mfacton/battle-bot/notes.txt

4s 850mah + 850mah
total 1700mah

Using 50A omni-wheels

40A is good softness
polyurethane rubber

14awg wire for split pigtails
10awg wire for combined wire

hello
