mfacton/battle-bot/pcb/battle-bot.step

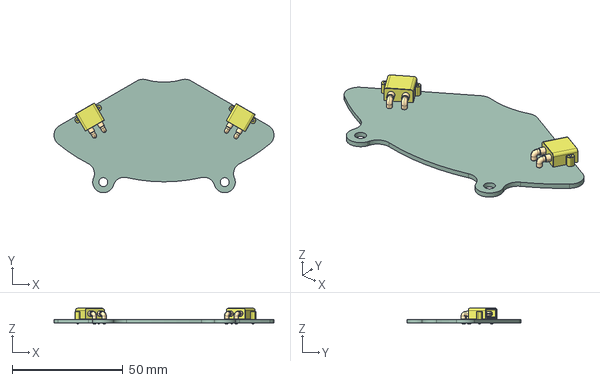
[picture p1: CAD file, 2024-11-22]
pcb/battle-bot.step
99.2 x 51.2 x 7.00 mm
XT30PW-M x 2
battle-bot_PCB
