mfacton/battle-bot/pcb/battle-bot.kicad_pcb

## KiCad design pcb/battle-bot.kicad_pcb (2024-11-30)

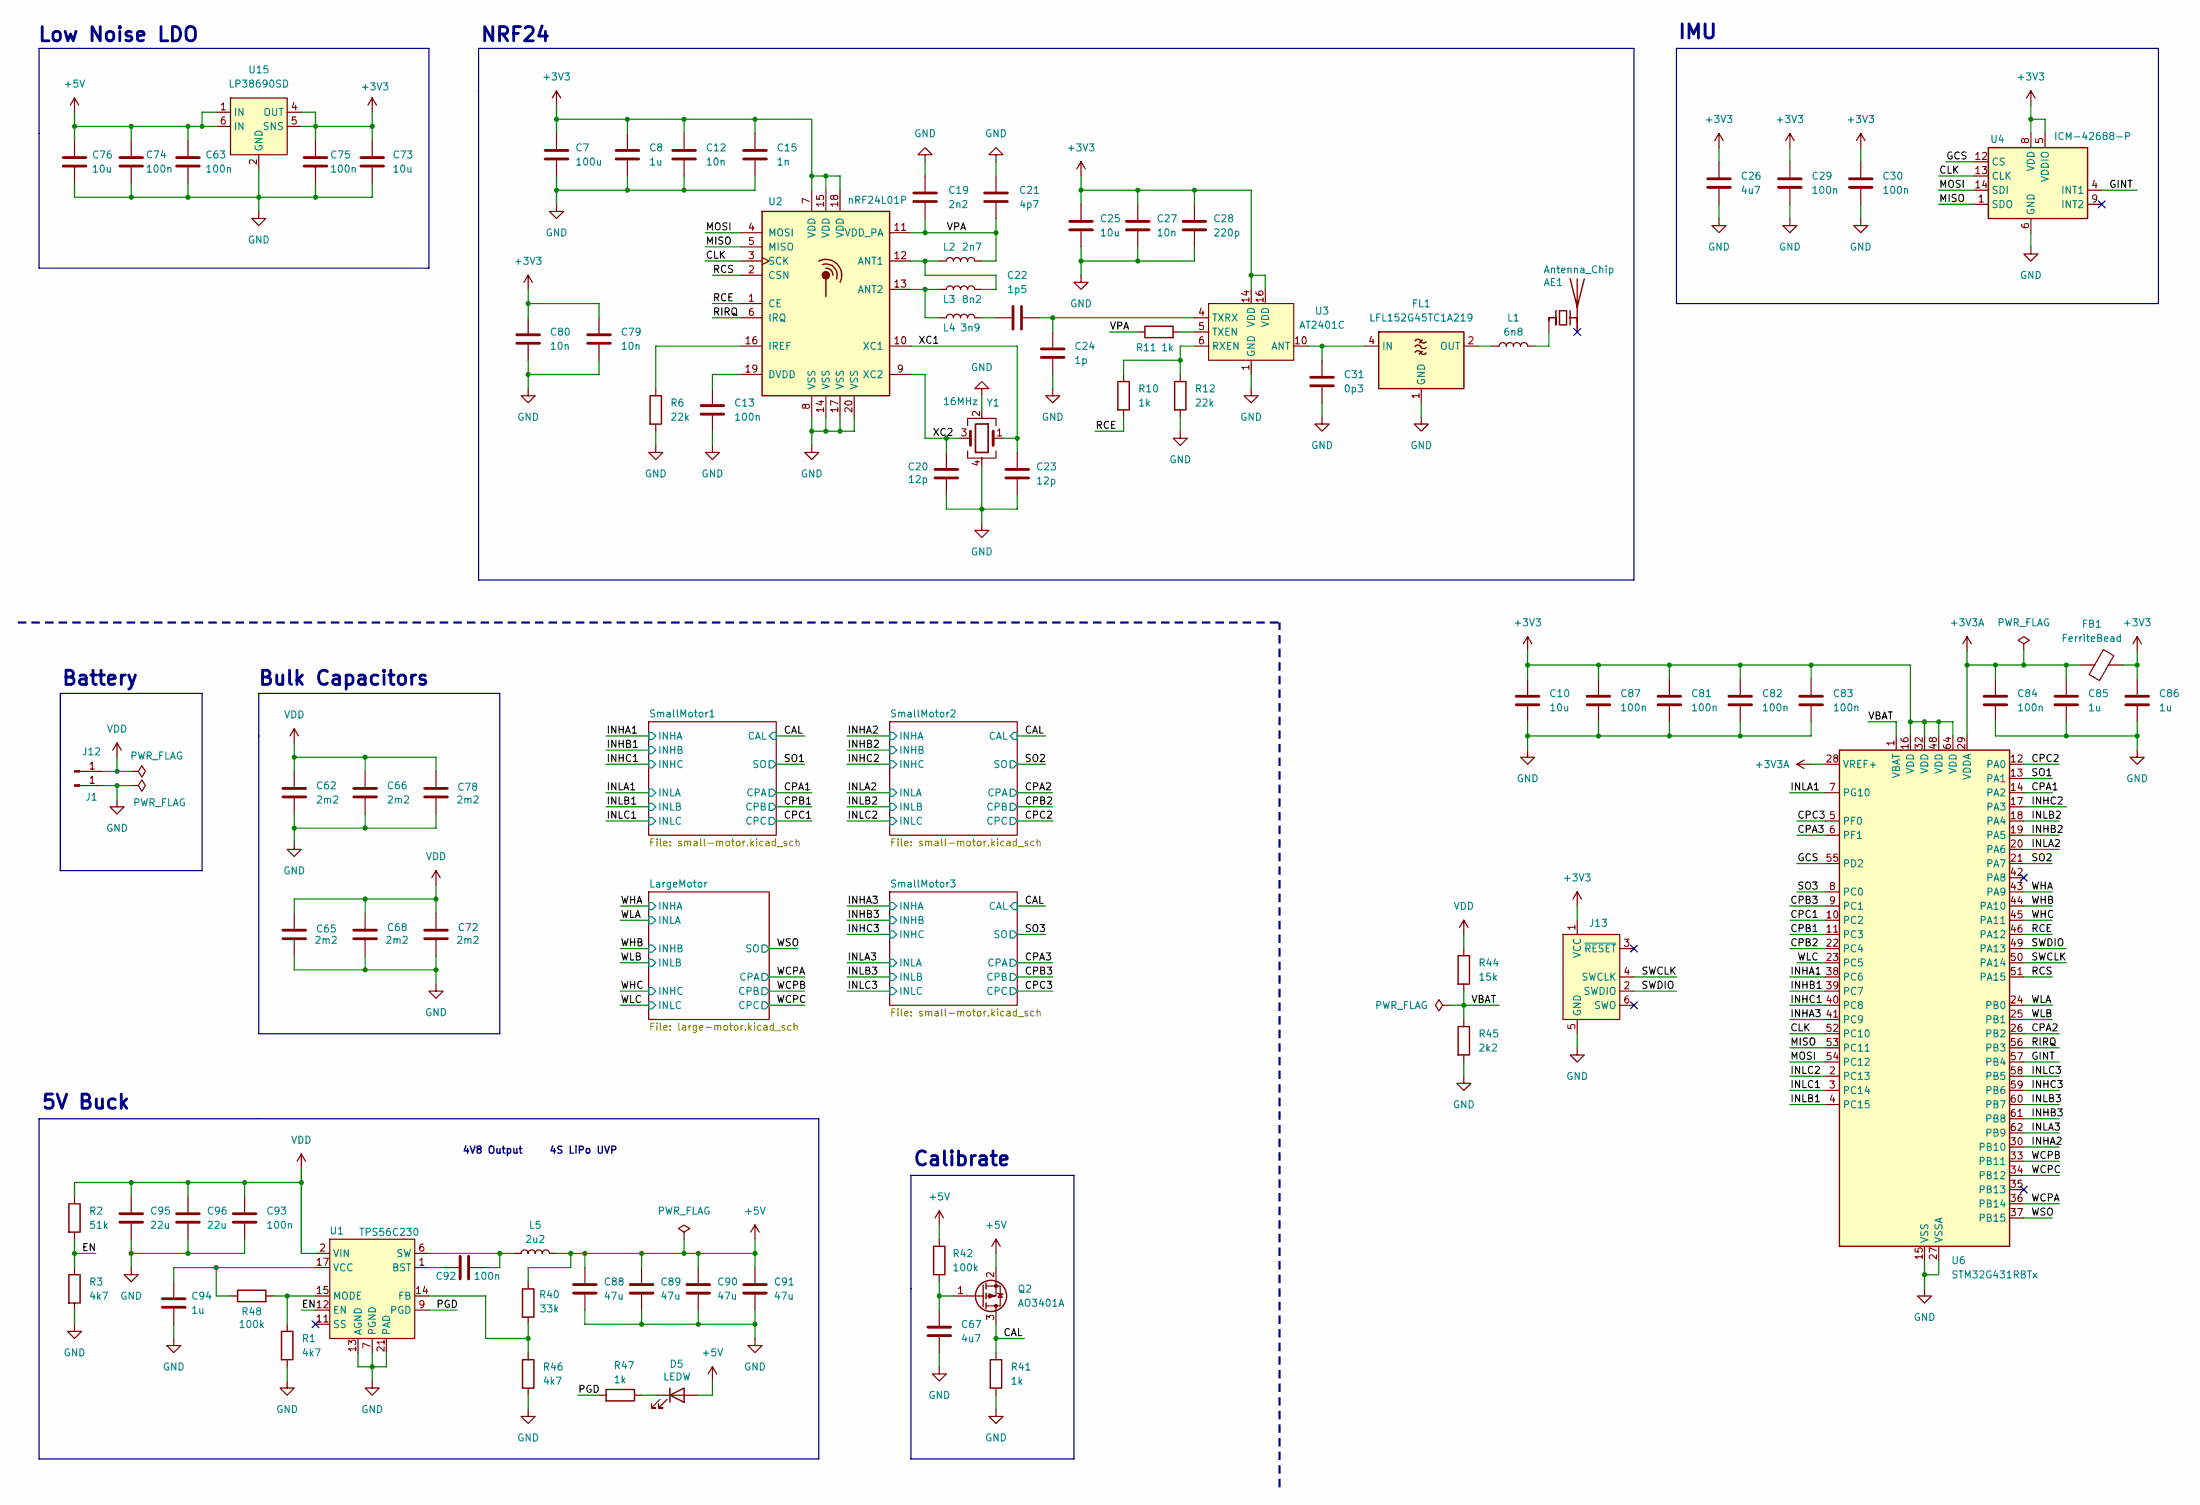
[picture p2: schematic battle-bot.kicad_sch]

Parts:
AE1: Antenna_Chip; Johanson_2450AT18x100; LCSC C127629
C7: 100u; C_1206_3216Metric; LCSC C15008
C8, C85, C86, C94: 1u; C_0402_1005Metric; LCSC C52923
C10, C25, C73: 10u; C_0402_1005Metric; LCSC C15525
C12, C27, C79, C80: 10n; C_0402_1005Metric; LCSC C15195
C13, C29, C30, C63, C74, C75, C81, C82, C83, C84, C87, C92: 100n; C_0402_1005Metric; LCSC C1525
C15: 1n; C_0402_1005Metric; LCSC C1523
C19: 2n2; C_0402_1005Metric; LCSC C1531
C20, C23: 12p; C_0402_1005Metric; LCSC C1547
C21: 4p7; C_0402_1005Metric; LCSC C1569
C22: 1p5; C_0402_1005Metric; LCSC C1552
C24: 1p; C_0402_1005Metric; LCSC C1550
C26, C67: 4u7; C_0402_1005Metric; LCSC C23733
C28: 220p; C_0402_1005Metric; LCSC C1530
C31: 0p3; C_0402_1005Metric; LCSC C880415
C62, C65, C66, C68, C72, C78: 2m2; C_D10xL16_Horizontal; LCSC C5438720
C76: 10u; C_0603_1608Metric; LCSC C19702
C88, C89, C90, C91: 47u; C_1206_3216Metric; LCSC C96123
C93: 100n; C_0402_1005Metric; LCSC C307331
C95, C96: 22u; C_0805_2012Metric; LCSC C45783
D5: LEDW; LED_0603_1608Metric; LCSC C2290
FB1: FerriteBead; L_0805_2012Metric; LCSC C1017
FL1: LFL152G45TC1A219; LCSC C91610
J1, J12: Conn_01x01_Pin; MountingHole_3.2mm_M3_Pad_Via
J13: Conn_ARM_SWD_TagConnect_TC2030-NL; Tag-Connect_TC2030-IDC-NL_2x03_P1.27mm_Vertical
L1: 6n8; L_0402_1005Metric; LCSC C82919
L2: 2n7; L_0402_1005Metric; LCSC C162541
L3: 8n2; L_0402_1005Metric; LCSC C84404
L4: 3n9; L_0402_1005Metric; LCSC C14033
L5: 2u2; L_Chilisin_BMRB00060618; LCSC C216189
Q2: AO3401A; SOT-23; LCSC C15127
R1, R3, R46: 4k7; R_0402_1005Metric; LCSC C25900
R2: 51k; R_0402_1005Metric; LCSC C25794
R6, R12: 22k; R_0402_1005Metric; LCSC C25768
R10, R11, R41, R47: 1k; R_0402_1005Metric; LCSC C11702
R40: 33k; R_0402_1005Metric; LCSC C25779
R42, R48: 100k; R_0402_1005Metric; LCSC C25741
R44: 15k; R_0402_1005Metric; LCSC C25756
R45: 2k2; R_0402_1005Metric; LCSC C25879
U1: TPS56C230; VQFN-20_3x3mm_P0.45; LCSC C1849534
U2: nRF24L01P; QFN-20-1EP_4x4mm_P0.5mm_EP2.5x2.5mm; LCSC C8791
U3: AT2401C; QFN-16-1EP_3x3mm_P0.5mm_EP1.7x1.7mm; LCSC C783588
U4: ICM-42688-P; LGA-14_3x2.5mm_P0.5mm_LayoutBorder3x4y
U6: STM32G431RBTx; LQFP-64_10x10mm_P0.5mm; LCSC C431633
U15: LP38690SD; DFN-6-1EP_3x3mm_P0.95mm_EP1.7x2.6mm; LCSC C130003
Y1: 16MHz; Crystal_SMD_3225-4Pin_3.2x2.5mm; LCSC C13738

Connections:
+3V3: C7.1, C8.1, C10.1, C12.1, C15.1, C25.1, C26.1, C27.1, C28.1, C29.1, C30.1, C73.1, C75.1, C79.1, C80.1, C81.1, C82.1, C83.1, C86.1, C87.1, FB1.2, J13.1 (VCC), U2.7 (VDD), U2.15 (VDD), U2.18 (VDD), U3.14 (VDD), U3.16 (VDD), U4.5 (VDDIO), U4.8 (VDD), U6.16 (VDD), U6.32 (VDD), U6.48 (VDD), U6.64 (VDD), U15.4 (OUT), U15.5 (SNS); also elsewhere on the board
+3V3A: C84.1, C85.1, FB1.1, U6.28 (VREF+), U6.29 (VDDA)
+5V: C63.1, C74.1, C76.1, C88.1, C89.1, C90.1, C91.1, D5.2 (A), L5.2, Q2.2 (S), R40.1, R42.1, U15.1 (IN), U15.6 (IN); also elsewhere on the board
/CAL: Q2.3 (D), R41.1; also elsewhere on the board
/CLK: U2.3 (SCK), U4.13 (CLK), U6.52 (PC10)
/CPA1: U6.14 (PA2); also elsewhere on the board
/CPA2: U6.26 (PB2); also elsewhere on the board
/CPA3: U6.6 (PF1); also elsewhere on the board
/CPB1: U6.11 (PC3); also elsewhere on the board
/CPB2: U6.22 (PC4); also elsewhere on the board
/CPB3: U6.9 (PC1); also elsewhere on the board
/CPC1: U6.10 (PC2); also elsewhere on the board
/CPC2: U6.12 (PA0); also elsewhere on the board
/CPC3: U6.5 (PF0); also elsewhere on the board
/EN: R2.2, R3.1, U1.12 (EN)
/GCS: U4.12 (CS), U6.55 (PD2)
/GINT: U4.4 (INT1), U6.57 (PB4)
/INHA1: U6.38 (PC6); also elsewhere on the board
/INHA2: U6.30 (PB10); also elsewhere on the board
/INHA3: U6.41 (PC9); also elsewhere on the board
/INHB1: U6.39 (PC7); also elsewhere on the board
/INHB2: U6.19 (PA5); also elsewhere on the board
/INHB3: U6.61 (PB8); also elsewhere on the board
/INHC1: U6.40 (PC8); also elsewhere on the board
/INHC2: U6.17 (PA3); also elsewhere on the board
/INHC3: U6.59 (PB6); also elsewhere on the board
/INLA1: U6.7 (PG10); also elsewhere on the board
/INLA2: U6.20 (PA6); also elsewhere on the board
/INLA3: U6.62 (PB9); also elsewhere on the board
/INLB1: U6.4 (PC15); also elsewhere on the board
/INLB2: U6.18 (PA4); also elsewhere on the board
/INLB3: U6.60 (PB7); also elsewhere on the board
/INLC1: U6.3 (PC14); also elsewhere on the board
/INLC2: U6.2 (PC13); also elsewhere on the board
/INLC3: U6.58 (PB5); also elsewhere on the board
/MISO: U2.5 (MISO), U4.1 (SDO), U6.53 (PC11)
/MOSI: U2.4 (MOSI), U4.14 (SDI), U6.54 (PC12)
/PGD: R47.2, U1.9 (PGD)
/RCE: R10.2, U2.1 (CE), U6.46 (PA12)
/RCS: U2.2 (CSN), U6.51 (PA15)
/RIRQ: U2.6 (IRQ), U6.56 (PB3)
/SO1: U6.13 (PA1); also elsewhere on the board
/SO2: U6.21 (PA7); also elsewhere on the board
/SO3: U6.8 (PC0); also elsewhere on the board
/SWCLK: J13.4 (SWCLK), U6.50 (PA14)
/SWDIO: J13.2 (SWDIO), U6.49 (PA13)
/VBAT: R44.2, R45.1, U6.1 (VBAT)
/VPA: C19.2, C21.1, L2.2, R11.1, U2.11 (VDD_PA)
/WCPA: U6.36 (PB14); also elsewhere on the board
/WCPB: U6.33 (PB11); also elsewhere on the board
/WCPC: U6.34 (PB12); also elsewhere on the board
/WHA: U6.43 (PA9); also elsewhere on the board
/WHB: U6.44 (PA10); also elsewhere on the board
/WHC: U6.45 (PA11); also elsewhere on the board
/WLA: U6.24 (PB0); also elsewhere on the board
/WLB: U6.25 (PB1); also elsewhere on the board
/WLC: U6.23 (PC5); also elsewhere on the board
/WSO: U6.37 (PB15); also elsewhere on the board
/XC1: C23.1, U2.10 (XC1), Y1.1
/XC2: C20.2, U2.9 (XC2), Y1.3
GND: C7.2, C8.2, C10.2, C12.2, C13.2, C15.2, C19.1, C20.1, C21.2, C23.2, C24.2, C25.2, C26.2, C27.2, C28.2, C29.2, C30.2, C31.2, C62.2, C63.2, C65.2, C66.1, C67.2, C68.2, C72.2, C73.2, C74.2, C75.2, C76.2, C78.2, C79.2, C80.2, C81.2, C82.2, C83.2, C84.2, C85.2, C86.2, C87.2, C88.2, C89.2, C90.2, C91.2, C93.2, C94.2, C95.2, C96.2, FL1.1 (GND), FL1.3 (GND), J1.1, J13.5 (GND), R1.2, R3.2, R6.2, R12.2, R41.2, R45.2, R46.2, U1.7 (PGND), U1.8 (PGND), U1.10 (NC), U1.13 (AGND), U1.16 (NC), U1.18 (PGND), U1.21 (PAD), U2.8 (VSS), U2.14 (VSS), U2.17 (VSS), U2.20 (VSS), U2.21 (VSS), U3.1 (GND), U3.2 (GND), U3.3 (GND), U3.7 (GND), U3.8 (GND), U3.9 (GND), U3.11 (GND), U3.12 (GND), U3.15 (GND), U3.17 (GND), U4.6 (GND), U4.7 (RESV), U4.11 (RESV), U6.15 (VSS), U6.27 (VSSA), U6.31 (VSS), U6.47 (VSS), U6.63 (VSS), U15.2 (GND), U15.7 (PAD), Y1.2, Y1.4; also elsewhere on the board
unnamed: AE1.1 (FEED), L1.2
unnamed: C22.1, L4.2
unnamed: C92.1, L5.1, U1.6 (SW), U1.19 (SW), U1.20 (SW)
unnamed: D5.1 (K), R47.1
unnamed: C31.1, FL1.4 (IN), U3.10 (ANT)
unnamed: FL1.2 (OUT), L1.1
unnamed: C67.1, Q2.1 (G), R42.2
unnamed: C92.2, U1.1 (BST)
unnamed: R40.2, R46.1, U1.14 (FB)
unnamed: R1.1, R48.2, U1.15 (MODE)
unnamed: C94.1, R48.1, U1.17 (VCC)
unnamed: L2.1, L3.2, U2.12 (ANT1)
unnamed: L3.1, L4.1, U2.13 (ANT2)
unnamed: C13.1, U2.19 (DVDD)
unnamed: R6.1, U2.16 (IREF)
unnamed: R10.1, R12.1, U3.6 (RXEN)
unnamed: R11.2, U3.5 (TXEN)
unnamed: C22.2, C24.1, U3.4 (TXRX)
VDD: C62.1, C65.1, C66.2, C68.1, C72.1, C78.1, C93.1, C95.1, C96.1, J12.1, R2.1, R44.1, U1.2 (VIN), U1.3 (VIN), U1.4 (VIN), U1.5 (VIN); also elsewhere on the board

Notes on the sheet:
Low Noise LDO
IMU
5V Buck
4S LiPo UVP
4V8 Output
Bulk Capacitors
Battery
Calibrate
NRF24

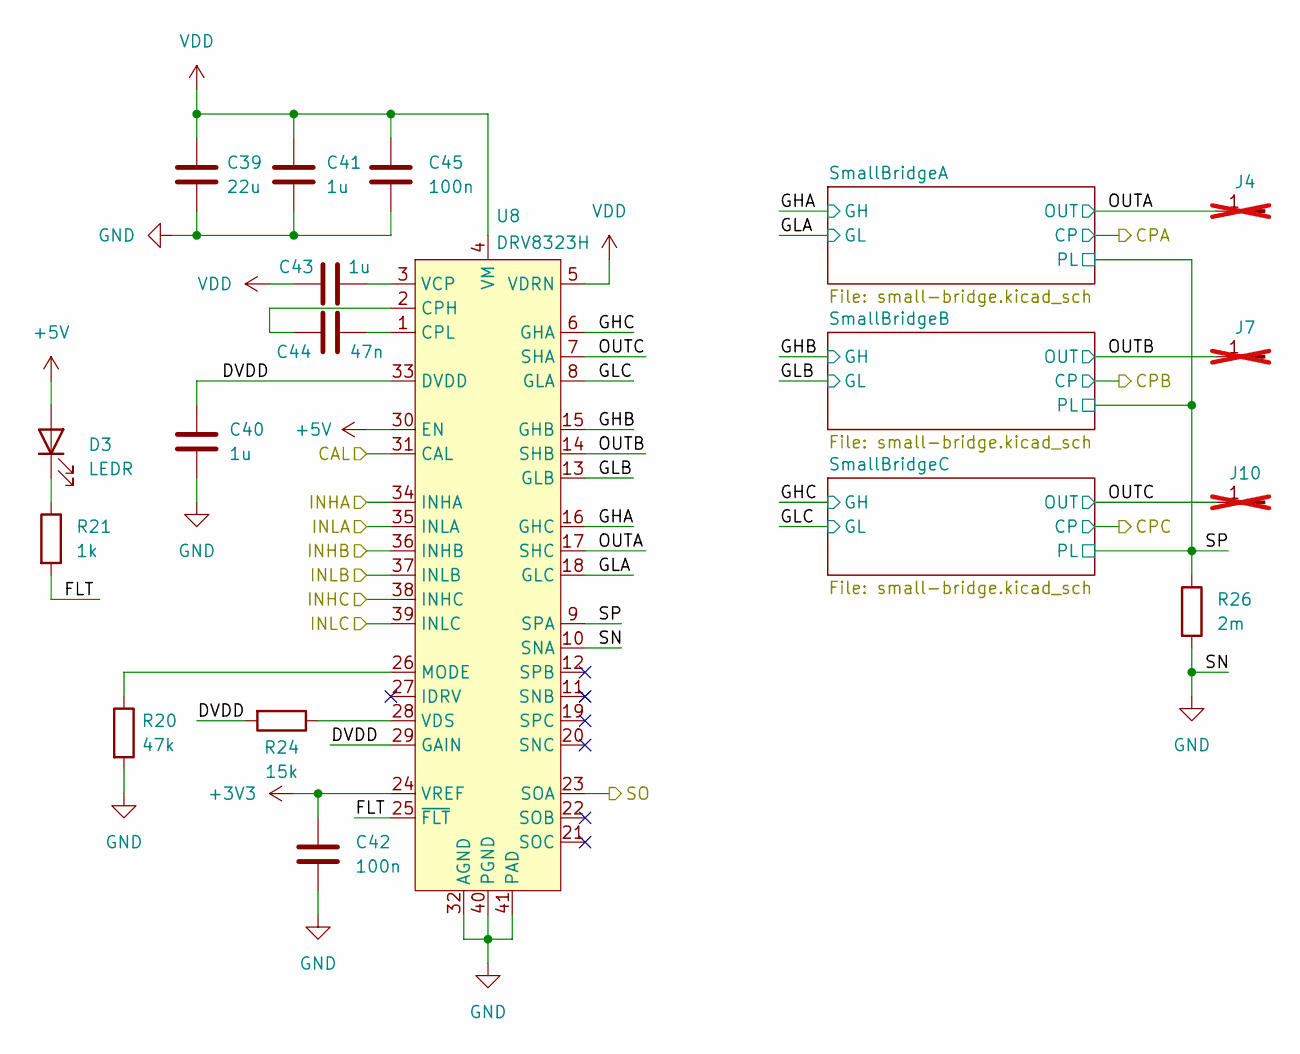
[picture p3: schematic small-motor.kicad_sch]

Parts:
C39: 22u; C_0805_2012Metric; LCSC C45783
C40, C43: 1u; C_0402_1005Metric; LCSC C52923
C41: 1u; R_0402_1005Metric; LCSC C52923
C42: 100n; C_0402_1005Metric; LCSC C1525
C44: 47n; C_0603_1608Metric; LCSC C1622
C45: 100n; C_0402_1005Metric; LCSC C307331
D3: LEDR; LED_0603_1608Metric; LCSC C2286
J4, J7, J10: Conn_01x01_Pin; Pad-P1.5; not fitted
R20: 47k; R_0402_1005Metric; LCSC C25792
R21: 1k; R_0402_1005Metric; LCSC C11702
R24: 15k; R_0402_1005Metric; LCSC C25756
R26: 2m; R_1206_3216Metric; LCSC C601094
U8: DRV8323H; HVQFN-40-1EP_6x6mm_P0.5mm_EP4.1x4.1mm; LCSC C701783

Connections:
+3V3: C42.1, U8.24 (VREF); also elsewhere on the board
+5V: D3.2 (A), U8.30 (EN); also elsewhere on the board
/CAL: U8.31 (CAL); also elsewhere on the board
/INHA2: U8.34 (INHA); also elsewhere on the board
/INHB2: U8.36 (INHB); also elsewhere on the board
/INHC2: U8.38 (INHC); also elsewhere on the board
/INLA2: U8.35 (INLA); also elsewhere on the board
/INLB2: U8.37 (INLB); also elsewhere on the board
/INLC2: U8.39 (INLC); also elsewhere on the board
/SO2: U8.23 (SOA); also elsewhere on the board
/SmallMotor2/DVDD: C40.1, R24.2, U8.29 (GAIN), U8.33 (DVDD)
/SmallMotor2/FLT: R21.2, U8.25 (~FLT)
/SmallMotor2/GHA: U8.16 (GHC); also elsewhere on the board
/SmallMotor2/GHB: U8.15 (GHB); also elsewhere on the board
/SmallMotor2/GHC: U8.6 (GHA); also elsewhere on the board
/SmallMotor2/GLA: U8.18 (GLC); also elsewhere on the board
/SmallMotor2/GLB: U8.13 (GLB); also elsewhere on the board
/SmallMotor2/GLC: U8.8 (GLA); also elsewhere on the board
/SmallMotor2/OUTA: J4.1, U8.17 (SHC); also elsewhere on the board
/SmallMotor2/OUTB: J7.1, U8.14 (SHB); also elsewhere on the board
/SmallMotor2/OUTC: J10.1, U8.7 (SHA); also elsewhere on the board
/SmallMotor2/SP: R26.1, U8.9 (SPA); also elsewhere on the board
GND: C39.2, C40.2, C41.2, C42.2, C45.2, R20.2, R26.2, U8.10 (SNA), U8.32 (AGND), U8.40 (PGND), U8.41 (PAD); also elsewhere on the board
unnamed: D3.1 (K), R21.1
unnamed: C44.1, U8.2 (CPH)
unnamed: C44.2, U8.1 (CPL)
unnamed: R20.1, U8.26 (MODE)
unnamed: C43.2, U8.3 (VCP)
unnamed: R24.1, U8.28 (VDS)
VDD: C39.1, C41.1, C43.1, C45.1, U8.4 (VM), U8.5 (VDRN); also elsewhere on the board

Parts of its further copies:
C32, C46: 22u; C_0805_2012Metric; LCSC C45783
C33, C36, C47, C50: 1u; C_0402_1005Metric; LCSC C52923
C34, C48: 1u; R_0402_1005Metric; LCSC C52923
C35, C49: 100n; C_0402_1005Metric; LCSC C1525
C37, C51: 47n; C_0603_1608Metric; LCSC C1622
C38, C52: 100n; C_0402_1005Metric; LCSC C307331
D2, D4: LEDR; LED_0603_1608Metric; LCSC C2286
J3, J5, J6, J8, J9, J11: Conn_01x01_Pin; Pad-P1.5; not fitted
R13, R27: 47k; R_0402_1005Metric; LCSC C25792
R14, R28: 1k; R_0402_1005Metric; LCSC C11702
R17, R31: 15k; R_0402_1005Metric; LCSC C25756
R19, R33: 2m; R_1206_3216Metric; LCSC C601094
U7, U9: DRV8323H; HVQFN-40-1EP_6x6mm_P0.5mm_EP4.1x4.1mm; LCSC C701783

Connections of its further copies:
+3V3: C35.1, C49.1, U7.24 (VREF), U9.24 (VREF); also elsewhere on the board
+5V: D2.2 (A), D4.2 (A), U7.30 (EN), U9.30 (EN); also elsewhere on the board
/CAL: U7.31 (CAL), U9.31 (CAL); also elsewhere on the board
/INHA1: U7.34 (INHA); also elsewhere on the board
/INHA3: U9.34 (INHA); also elsewhere on the board
/INHB1: U7.36 (INHB); also elsewhere on the board
/INHB3: U9.36 (INHB); also elsewhere on the board
/INHC1: U7.38 (INHC); also elsewhere on the board
/INHC3: U9.38 (INHC); also elsewhere on the board
/INLA1: U7.35 (INLA); also elsewhere on the board
/INLA3: U9.35 (INLA); also elsewhere on the board
/INLB1: U7.37 (INLB); also elsewhere on the board
/INLB3: U9.37 (INLB); also elsewhere on the board
/INLC1: U7.39 (INLC); also elsewhere on the board
/INLC3: U9.39 (INLC); also elsewhere on the board
/SO1: U7.23 (SOA); also elsewhere on the board
/SO3: U9.23 (SOA); also elsewhere on the board
/SmallMotor1/DVDD: C33.1, R17.2, U7.29 (GAIN), U7.33 (DVDD)
/SmallMotor1/FLT: R14.2, U7.25 (~FLT)
/SmallMotor1/GHA: U7.16 (GHC); also elsewhere on the board
/SmallMotor1/GHB: U7.15 (GHB); also elsewhere on the board
/SmallMotor1/GHC: U7.6 (GHA); also elsewhere on the board
/SmallMotor1/GLA: U7.18 (GLC); also elsewhere on the board
/SmallMotor1/GLB: U7.13 (GLB); also elsewhere on the board
/SmallMotor1/GLC: U7.8 (GLA); also elsewhere on the board
/SmallMotor1/OUTA: J3.1, U7.17 (SHC); also elsewhere on the board
/SmallMotor1/OUTB: J6.1, U7.14 (SHB); also elsewhere on the board
/SmallMotor1/OUTC: J9.1, U7.7 (SHA); also elsewhere on the board
/SmallMotor1/SP: R19.1, U7.9 (SPA); also elsewhere on the board
/SmallMotor3/DVDD: C47.1, R31.2, U9.29 (GAIN), U9.33 (DVDD)
/SmallMotor3/FLT: R28.2, U9.25 (~FLT)
/SmallMotor3/GHA: U9.16 (GHC); also elsewhere on the board
/SmallMotor3/GHB: U9.15 (GHB); also elsewhere on the board
/SmallMotor3/GHC: U9.6 (GHA); also elsewhere on the board
/SmallMotor3/GLA: U9.18 (GLC); also elsewhere on the board
/SmallMotor3/GLB: U9.13 (GLB); also elsewhere on the board
/SmallMotor3/GLC: U9.8 (GLA); also elsewhere on the board
/SmallMotor3/OUTA: J5.1, U9.17 (SHC); also elsewhere on the board
/SmallMotor3/OUTB: J8.1, U9.14 (SHB); also elsewhere on the board
/SmallMotor3/OUTC: J11.1, U9.7 (SHA); also elsewhere on the board
/SmallMotor3/SP: R33.1, U9.9 (SPA); also elsewhere on the board
GND: C32.2, C33.2, C34.2, C35.2, C38.2, C46.2, C47.2, C48.2, C49.2, C52.2, R13.2, R19.2, R27.2, R33.2, U7.10 (SNA), U7.32 (AGND), U7.40 (PGND), U7.41 (PAD), U9.10 (SNA), U9.32 (AGND), U9.40 (PGND), U9.41 (PAD); also elsewhere on the board
unnamed: D2.1 (K), R14.1
unnamed: D4.1 (K), R28.1
unnamed: C37.1, U7.2 (CPH)
unnamed: C37.2, U7.1 (CPL)
unnamed: R13.1, U7.26 (MODE)
unnamed: C36.2, U7.3 (VCP)
unnamed: R17.1, U7.28 (VDS)
unnamed: C51.1, U9.2 (CPH)
unnamed: C51.2, U9.1 (CPL)
unnamed: R27.1, U9.26 (MODE)
unnamed: C50.2, U9.3 (VCP)
unnamed: R31.1, U9.28 (VDS)
VDD: C32.1, C34.1, C36.1, C38.1, C46.1, C48.1, C50.1, C52.1, U7.4 (VM), U7.5 (VDRN), U9.4 (VM), U9.5 (VDRN); also elsewhere on the board

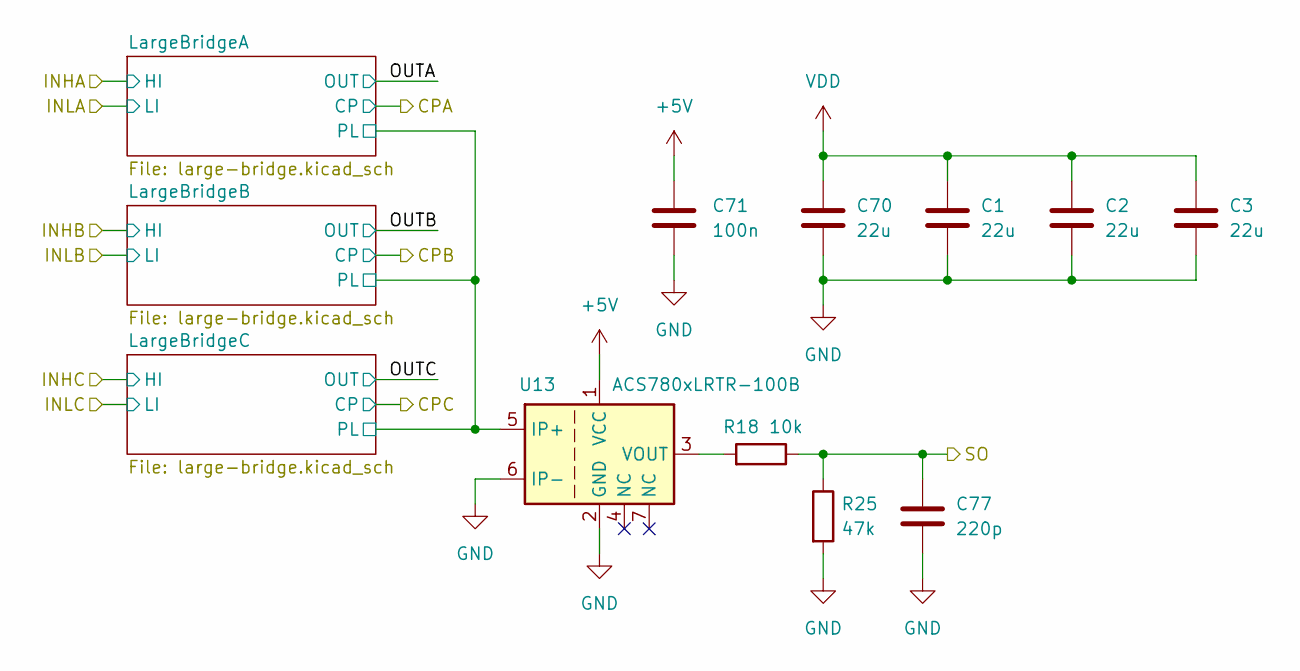
[picture p4: schematic large-motor.kicad_sch]

Parts:
C1, C2, C3, C70: 22u; C_0805_2012Metric; LCSC C45783
C71: 100n; C_0402_1005Metric; LCSC C1525
C77: 220p; R_0402_1005Metric; LCSC C1530
R18: 10k; R_0402_1005Metric; LCSC C25744
R25: 47k; R_0402_1005Metric; LCSC C25792
U13: ACS780xLRTR-100B; Allegro_PSOF-7_4.8x6.4mm_P1.60mm; LCSC C97317

Connections:
+5V: C71.1, U13.1 (VCC); also elsewhere on the board
/LargeMotor/LargeBridgeA/PL: U13.5 (IP+); also elsewhere on the board
/WSO: C77.1, R18.1, R25.1; also elsewhere on the board
GND: C1.2, C2.2, C3.2, C70.2, C71.2, C77.2, R25.2, U13.2 (GND), U13.6 (IP-); also elsewhere on the board
unnamed: R18.2, U13.3 (VOUT)
VDD: C1.1, C2.1, C3.1, C70.1; also elsewhere on the board

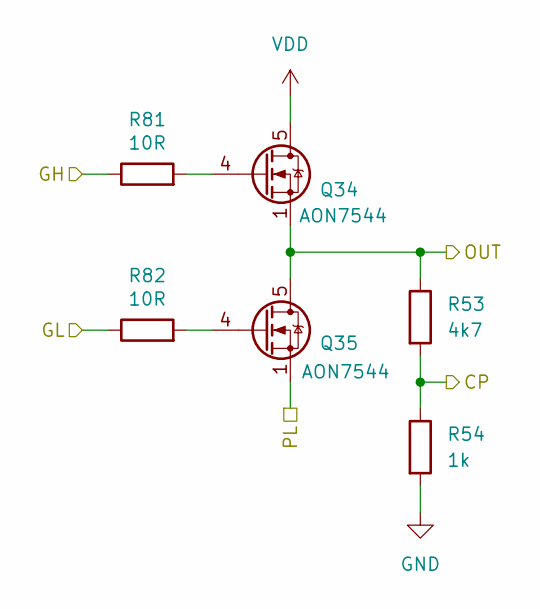
[picture p5: schematic small-bridge.kicad_sch]

Parts:
Q34, Q35: AON7544; DFN3x3A_8L_EP1_P; LCSC C315567
R53: 4k7; R_0402_1005Metric; LCSC C25900
R54: 1k; R_0402_1005Metric; LCSC C11702
R81, R82: 10R; R_0402_1005Metric; LCSC C25077

Connections:
/CPC2: R53.2, R54.1; also elsewhere on the board
/SmallMotor2/GHC: R81.1; also elsewhere on the board
/SmallMotor2/GLC: R82.1; also elsewhere on the board
/SmallMotor2/OUTC: Q34.1 (S), Q34.2 (S), Q34.3 (S), Q35.5 (D), Q35.6 (D), Q35.7 (D), Q35.8 (D), R53.1; also elsewhere on the board
/SmallMotor2/SP: Q35.1 (S), Q35.2 (S), Q35.3 (S); also elsewhere on the board
GND: R54.2; also elsewhere on the board
unnamed: Q34.4 (G), R81.2
unnamed: Q35.4 (G), R82.2
VDD: Q34.5 (D), Q34.6 (D), Q34.7 (D), Q34.8 (D); also elsewhere on the board

Parts of its further copies:
Q1, Q27, Q28, Q29, Q30, Q31, Q32, Q33, Q36, Q37, Q38, Q39, Q40, Q41, Q42, Q43: AON7544; DFN3x3A_8L_EP1_P; LCSC C315567
R49, R51, R55, R57, R59, R64, R66, R71: 4k7; R_0402_1005Metric; LCSC C25900
R50, R52, R56, R58, R60, R65, R70, R72: 1k; R_0402_1005Metric; LCSC C11702
R73, R74, R75, R76, R77, R78, R79, R80, R83, R84, R85, R86, R87, R88, R89, R90: 10R; R_0402_1005Metric; LCSC C25077

Connections of its further copies:
/CPA1: R57.2, R58.1; also elsewhere on the board
/CPA2: R59.2, R60.1; also elsewhere on the board
/CPA3: R64.2, R65.1; also elsewhere on the board
/CPB1: R66.2, R70.1; also elsewhere on the board
/CPB2: R71.2, R72.1; also elsewhere on the board
/CPB3: R49.2, R50.1; also elsewhere on the board
/CPC1: R51.2, R52.1; also elsewhere on the board
/CPC3: R55.2, R56.1; also elsewhere on the board
/SmallMotor1/GHA: R85.1; also elsewhere on the board
/SmallMotor1/GHB: R75.1; also elsewhere on the board
/SmallMotor1/GHC: R79.1; also elsewhere on the board
/SmallMotor1/GLA: R86.1; also elsewhere on the board
/SmallMotor1/GLB: R76.1; also elsewhere on the board
/SmallMotor1/GLC: R80.1; also elsewhere on the board
/SmallMotor1/OUTA: Q38.1 (S), Q38.2 (S), Q38.3 (S), Q39.5 (D), Q39.6 (D), Q39.7 (D), Q39.8 (D), R57.1; also elsewhere on the board
/SmallMotor1/OUTB: Q28.1 (S), Q28.2 (S), Q28.3 (S), Q29.5 (D), Q29.6 (D), Q29.7 (D), Q29.8 (D), R66.1; also elsewhere on the board
/SmallMotor1/OUTC: Q32.1 (S), Q32.2 (S), Q32.3 (S), Q33.5 (D), Q33.6 (D), Q33.7 (D), Q33.8 (D), R51.1; also elsewhere on the board
/SmallMotor1/SP: Q29.1 (S), Q29.2 (S), Q29.3 (S), Q33.1 (S), Q33.2 (S), Q33.3 (S), Q39.1 (S), Q39.2 (S), Q39.3 (S); also elsewhere on the board
/SmallMotor2/GHA: R87.1; also elsewhere on the board
/SmallMotor2/GHB: R77.1; also elsewhere on the board
/SmallMotor2/GLA: R88.1; also elsewhere on the board
/SmallMotor2/GLB: R78.1; also elsewhere on the board
/SmallMotor2/OUTA: Q40.1 (S), Q40.2 (S), Q40.3 (S), Q41.5 (D), Q41.6 (D), Q41.7 (D), Q41.8 (D), R59.1; also elsewhere on the board
/SmallMotor2/OUTB: Q30.1 (S), Q30.2 (S), Q30.3 (S), Q31.5 (D), Q31.6 (D), Q31.7 (D), Q31.8 (D), R71.1; also elsewhere on the board
/SmallMotor2/SP: Q31.1 (S), Q31.2 (S), Q31.3 (S), Q41.1 (S), Q41.2 (S), Q41.3 (S); also elsewhere on the board
/SmallMotor3/GHA: R89.1; also elsewhere on the board
/SmallMotor3/GHB: R73.1; also elsewhere on the board
/SmallMotor3/GHC: R83.1; also elsewhere on the board
/SmallMotor3/GLA: R90.1; also elsewhere on the board
/SmallMotor3/GLB: R74.1; also elsewhere on the board
/SmallMotor3/GLC: R84.1; also elsewhere on the board
/SmallMotor3/OUTA: Q42.1 (S), Q42.2 (S), Q42.3 (S), Q43.5 (D), Q43.6 (D), Q43.7 (D), Q43.8 (D), R64.1; also elsewhere on the board
/SmallMotor3/OUTB: Q1.1 (S), Q1.2 (S), Q1.3 (S), Q27.5 (D), Q27.6 (D), Q27.7 (D), Q27.8 (D), R49.1; also elsewhere on the board
/SmallMotor3/OUTC: Q36.1 (S), Q36.2 (S), Q36.3 (S), Q37.5 (D), Q37.6 (D), Q37.7 (D), Q37.8 (D), R55.1; also elsewhere on the board
/SmallMotor3/SP: Q27.1 (S), Q27.2 (S), Q27.3 (S), Q37.1 (S), Q37.2 (S), Q37.3 (S), Q43.1 (S), Q43.2 (S), Q43.3 (S); also elsewhere on the board
GND: R50.2, R52.2, R56.2, R58.2, R60.2, R65.2, R70.2, R72.2; also elsewhere on the board
unnamed: Q1.4 (G), R73.2
unnamed: Q27.4 (G), R74.2
unnamed: Q28.4 (G), R75.2
unnamed: Q29.4 (G), R76.2
unnamed: Q30.4 (G), R77.2
unnamed: Q31.4 (G), R78.2
unnamed: Q32.4 (G), R79.2
unnamed: Q33.4 (G), R80.2
unnamed: Q36.4 (G), R83.2
unnamed: Q37.4 (G), R84.2
unnamed: Q38.4 (G), R85.2
unnamed: Q39.4 (G), R86.2
unnamed: Q40.4 (G), R87.2
unnamed: Q41.4 (G), R88.2
unnamed: Q42.4 (G), R89.2
unnamed: Q43.4 (G), R90.2
VDD: Q1.5 (D), Q1.6 (D), Q1.7 (D), Q1.8 (D), Q28.5 (D), Q28.6 (D), Q28.7 (D), Q28.8 (D), Q30.5 (D), Q30.6 (D), Q30.7 (D), Q30.8 (D), Q32.5 (D), Q32.6 (D), Q32.7 (D), Q32.8 (D), Q36.5 (D), Q36.6 (D), Q36.7 (D), Q36.8 (D), Q38.5 (D), Q38.6 (D), Q38.7 (D), Q38.8 (D), Q40.5 (D), Q40.6 (D), Q40.7 (D), Q40.8 (D), Q42.5 (D), Q42.6 (D), Q42.7 (D), Q42.8 (D); also elsewhere on the board

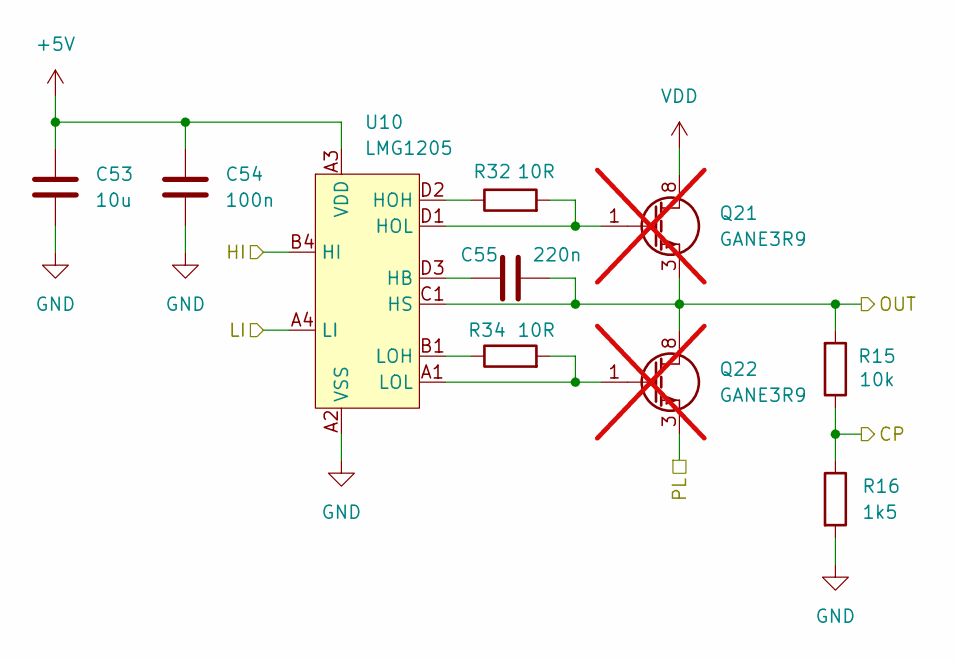
[picture p6: schematic large-bridge.kicad_sch]

Parts:
C53: 10u; C_0603_1608Metric; LCSC C19702
C54: 100n; C_0402_1005Metric; LCSC C1525
C55: 220n; C_0402_1005Metric; LCSC C16772
Q21, Q22: GANE3R9; not fitted
R15: 10k; R_0402_1005Metric; LCSC C25744
R16: 1k5; R_0402_1005Metric; LCSC C25867
R32, R34: 10R; R_0402_1005Metric; LCSC C25077
U10: LMG1205; LCSC C2653814

Connections:
+5V: C53.1, C54.1, U10.A3 (VDD), U10.C4 (VDD); also elsewhere on the board
/LargeMotor/LargeBridgeA/PL: Q22.3 (S), Q22.4 (S), Q22.5 (S), Q22.6 (S), Q22.7 (S), Q22.9 (S), Q22.11 (S), Q22.21 (S), Q22.23 (S); also elsewhere on the board
/LargeMotor/OUTA: C55.2, Q21.3 (S), Q21.4 (S), Q21.5 (S), Q21.6 (S), Q21.7 (S), Q21.9 (S), Q21.11 (S), Q21.21 (S), Q21.23 (S), Q22.8 (D), Q22.10 (D), Q22.12 (D), Q22.13 (D), Q22.14 (D), Q22.15 (D), Q22.16 (D), Q22.17 (D), Q22.18 (D), Q22.19 (D), Q22.20 (D), Q22.22 (D), Q22.24 (D), R15.2, U10.C1 (HS), U10.D4 (HS)
/WCPA: R15.1, R16.1; also elsewhere on the board
/WHA: U10.B4 (HI); also elsewhere on the board
/WLA: U10.A4 (LI); also elsewhere on the board
GND: C53.2, C54.2, R16.2, U10.A2 (VSS); also elsewhere on the board
unnamed: C55.1, U10.D3 (HB)
unnamed: R32.1, U10.D2 (HOH)
unnamed: Q21.1 (G), Q21.2 (G), Q21.25 (G), R32.2, U10.D1 (HOL)
unnamed: R34.1, U10.B1 (LOH)
unnamed: Q22.1 (G), Q22.2 (G), Q22.25 (G), R34.2, U10.A1 (LOL)
VDD: Q21.8 (D), Q21.10 (D), Q21.12 (D), Q21.13 (D), Q21.14 (D), Q21.15 (D), Q21.16 (D), Q21.17 (D), Q21.18 (D), Q21.19 (D), Q21.20 (D), Q21.22 (D), Q21.24 (D); also elsewhere on the board

Parts of its further copies:
C56, C59: 10u; C_0603_1608Metric; LCSC C19702
C57, C60: 100n; C_0402_1005Metric; LCSC C1525
C58, C61: 220n; C_0402_1005Metric; LCSC C16772
Q23, Q24, Q25, Q26: GANE3R9; not fitted
R22, R29: 10k; R_0402_1005Metric; LCSC C25744
R23, R30: 1k5; R_0402_1005Metric; LCSC C25867
R35, R36, R37, R38: 10R; R_0402_1005Metric; LCSC C25077
U11, U12: LMG1205; LCSC C2653814

Connections of its further copies:
+5V: C56.1, C57.1, C59.1, C60.1, U11.A3 (VDD), U11.C4 (VDD), U12.A3 (VDD), U12.C4 (VDD); also elsewhere on the board
/LargeMotor/LargeBridgeA/PL: Q24.3 (S), Q24.4 (S), Q24.5 (S), Q24.6 (S), Q24.7 (S), Q24.9 (S), Q24.11 (S), Q24.21 (S), Q24.23 (S), Q26.3 (S), Q26.4 (S), Q26.5 (S), Q26.6 (S), Q26.7 (S), Q26.9 (S), Q26.11 (S), Q26.21 (S), Q26.23 (S); also elsewhere on the board
/LargeMotor/OUTB: C58.2, Q23.3 (S), Q23.4 (S), Q23.5 (S), Q23.6 (S), Q23.7 (S), Q23.9 (S), Q23.11 (S), Q23.21 (S), Q23.23 (S), Q24.8 (D), Q24.10 (D), Q24.12 (D), Q24.13 (D), Q24.14 (D), Q24.15 (D), Q24.16 (D), Q24.17 (D), Q24.18 (D), Q24.19 (D), Q24.20 (D), Q24.22 (D), Q24.24 (D), R22.2, U11.C1 (HS), U11.D4 (HS)
/LargeMotor/OUTC: C61.2, Q25.3 (S), Q25.4 (S), Q25.5 (S), Q25.6 (S), Q25.7 (S), Q25.9 (S), Q25.11 (S), Q25.21 (S), Q25.23 (S), Q26.8 (D), Q26.10 (D), Q26.12 (D), Q26.13 (D), Q26.14 (D), Q26.15 (D), Q26.16 (D), Q26.17 (D), Q26.18 (D), Q26.19 (D), Q26.20 (D), Q26.22 (D), Q26.24 (D), R29.2, U12.C1 (HS), U12.D4 (HS)
/WCPB: R22.1, R23.1; also elsewhere on the board
/WCPC: R29.1, R30.1; also elsewhere on the board
/WHB: U11.B4 (HI); also elsewhere on the board
/WHC: U12.B4 (HI); also elsewhere on the board
/WLB: U11.A4 (LI); also elsewhere on the board
/WLC: U12.A4 (LI); also elsewhere on the board
GND: C56.2, C57.2, C59.2, C60.2, R23.2, R30.2, U11.A2 (VSS), U12.A2 (VSS); also elsewhere on the board
unnamed: C58.1, U11.D3 (HB)
unnamed: R35.1, U11.D2 (HOH)
unnamed: Q23.1 (G), Q23.2 (G), Q23.25 (G), R35.2, U11.D1 (HOL)
unnamed: R36.1, U11.B1 (LOH)
unnamed: Q24.1 (G), Q24.2 (G), Q24.25 (G), R36.2, U11.A1 (LOL)
unnamed: C61.1, U12.D3 (HB)
unnamed: R37.1, U12.D2 (HOH)
unnamed: Q25.1 (G), Q25.2 (G), Q25.25 (G), R37.2, U12.D1 (HOL)
unnamed: R38.1, U12.B1 (LOH)
unnamed: Q26.1 (G), Q26.2 (G), Q26.25 (G), R38.2, U12.A1 (LOL)
VDD: Q23.8 (D), Q23.10 (D), Q23.12 (D), Q23.13 (D), Q23.14 (D), Q23.15 (D), Q23.16 (D), Q23.17 (D), Q23.18 (D), Q23.19 (D), Q23.20 (D), Q23.22 (D), Q23.24 (D), Q25.8 (D), Q25.10 (D), Q25.12 (D), Q25.13 (D), Q25.14 (D), Q25.15 (D), Q25.16 (D), Q25.17 (D), Q25.18 (D), Q25.19 (D), Q25.20 (D), Q25.22 (D), Q25.24 (D); also elsewhere on the board

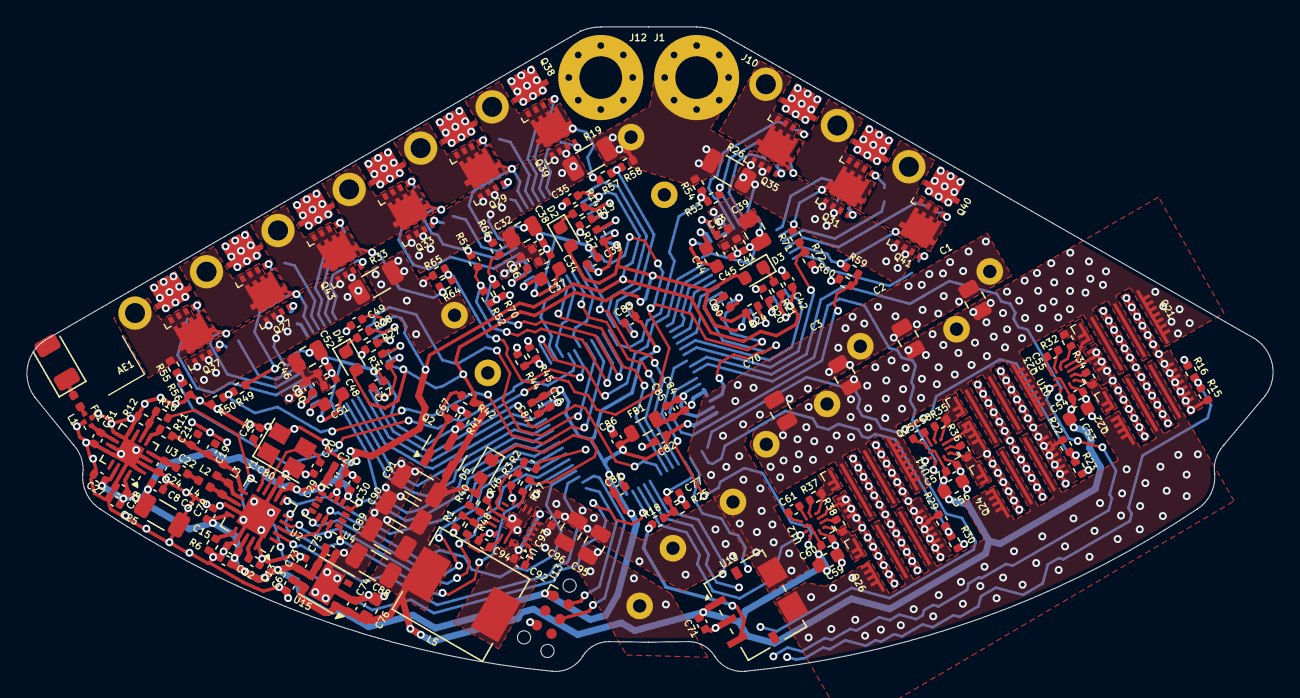
[picture p7: board battle-bot.kicad_pcb from above]

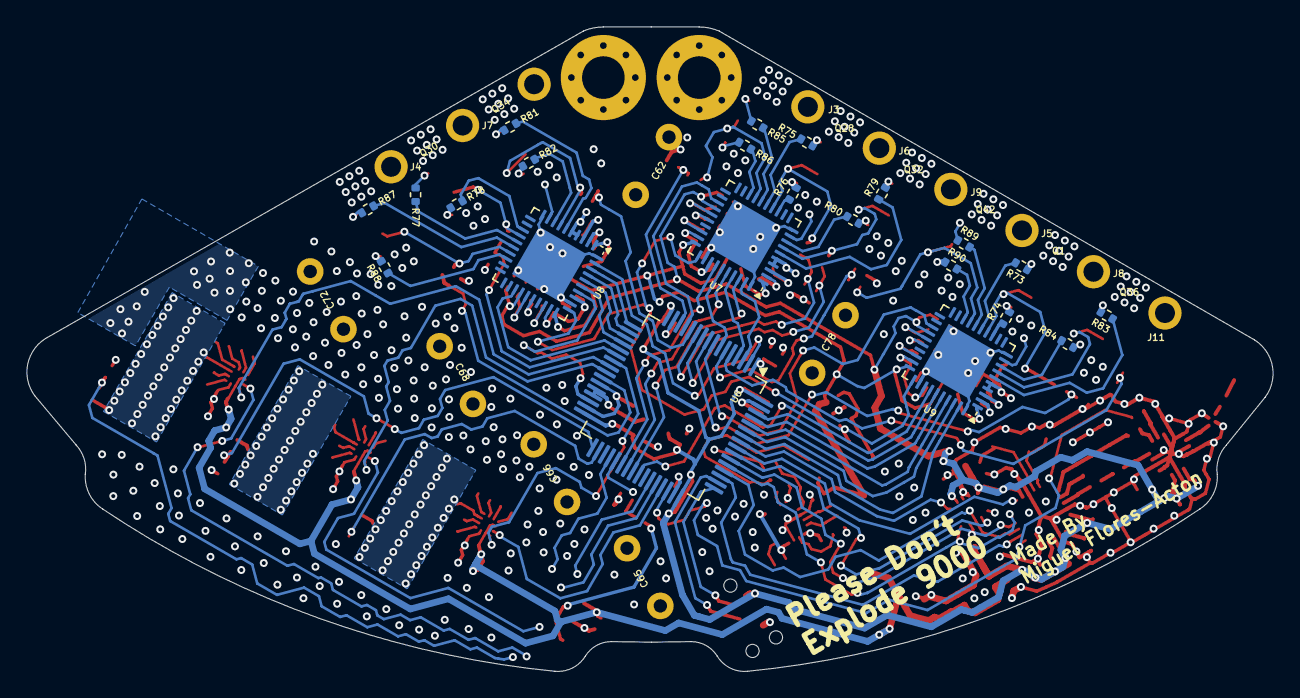
[picture p8: board battle-bot.kicad_pcb from below]

Board: 4 copper layers, 93.6 x 48.4 mm, 225 parts (28 on the bottom side), 172 nets.
