mfacton/battle-bot/firmware/battle-bot/battle-bot.ioc

Mcu.UserName=STM32G431RBTx
PA0.Signal=ADC1_IN1
PA1.Signal=ADC1_IN2
PA10.Signal=S_TIM1_CH3
PA11.Signal=S_TIM1_CH4
PA12.Signal=GPIO_Output
PA13.Signal=SYS_JTMS-SWDIO
PA14.Signal=SYS_JTCK-SWCLK
PA15.Signal=GPIO_Output
PA2.Signal=ADC1_IN3
PA3.Signal=S_TIM15_CH2
PA4.Signal=GPIO_Output
PA5.Signal=S_TIM2_CH1
PA6.Signal=GPIO_Output
PA7.Signal=ADC2_IN4
PA9.Signal=S_TIM1_CH2
PB0.Signal=TIM1_CH2N
PB1.Signal=TIM1_CH3N
PB10.Signal=S_TIM2_CH3
PB11.Signal=ADC1_IN14
PB12.Signal=ADC1_IN11
PB14.Signal=ADC1_IN5
PB15.Signal=ADC2_IN15
PB2.Signal=ADC2_IN12
PB3.Signal=GPXTI3
PB4.Signal=GPXTI4
PB5.Signal=GPIO_Output
PB6.Signal=S_TIM4_CH1
PB7.Signal=GPIO_Output
PB8-BOOT0.Signal=S_TIM4_CH3
PB9.Signal=GPIO_Output
PC0.Signal=ADC1_IN6
PC1.Signal=ADC1_IN7
PC10.Signal=SPI3_SCK
PC11.Signal=SPI3_MISO
PC12.Signal=SPI3_MOSI
PC13.Signal=GPIO_Output
PC14-OSC32_IN.Signal=GPIO_Output
PC15-OSC32_OUT.Signal=GPIO_Output
PC2.Signal=ADC1_IN8
PC3.Signal=ADC1_IN9
PC4.Signal=ADC2_IN5
PC5.Signal=TIM1_CH4N
PC6.Signal=S_TIM3_CH1
PC7.Signal=S_TIM3_CH2
PC8.Signal=S_TIM3_CH3
PC9.Signal=S_TIM3_CH4
PD2.Signal=GPIO_Output
PF0-OSC_IN.Signal=ADC1_IN10
PF1-OSC_OUT.Signal=ADC2_IN10
PG10-NRST.Signal=GPIO_Output
