mfacton/battle-bot/(commit log)

2024-11-17 Make pcb
    [battle-bot.kicad_pcb, battle-bot.kicad_sch]
2024-11-22 Place power connectors
    [battle-bot.kicad_pcb, battle-bot.step]
2024-11-24 Finish drivers
    [battle-bot.kicad_pcb, battle-bot.kicad_sch, bom.csv, designators.csv, large-bridge.kicad_sch, large-motor.kicad_sch, positions.csv, small-bridge.kicad_sch]
2024-11-26 Finish rough layout
    [battle-bot.kicad_pcb, battle-bot.kicad_sch, large-bridge.kicad_sch, large-motor.kicad_sch, small-bridge.kicad_sch, small-motor.kicad_sch]
2024-11-27 Save layout
    [battle-bot.kicad_pcb, battle-bot.kicad_sch, small-motor.kicad_sch]
2024-11-29 Save old buck regulator
    [battle-bot.kicad_pcb, battle-bot.kicad_sch, large-bridge.kicad_sch, large-motor.kicad_sch, small-motor.kicad_sch]
2024-11-30 Finish pcb
    [battle-bot.kicad_pcb, battle-bot.kicad_sch, bom.csv, designators.csv, large-motor.kicad_sch, positions.csv, small-bridge.kicad_sch, small-motor.kicad_sch]
